Dhairya-Dev-Singh/Pocket-Arcade/CAD/arcade_base.stl

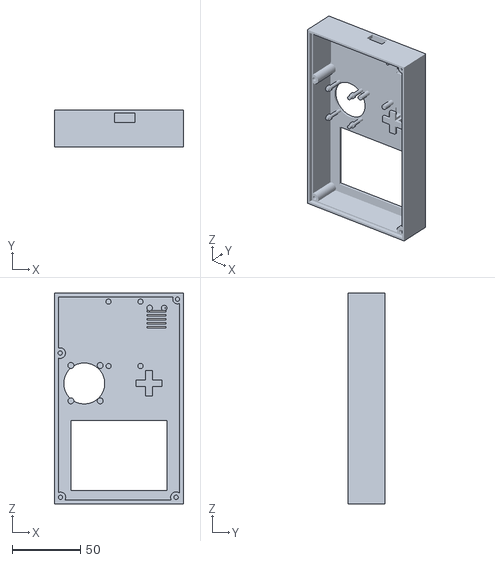
[picture p1: CAD file, 2026-11-06]
CAD/arcade_base.stl
95.0 x 27.0 x 155.0
