Dhairya-Dev-Singh/Pocket-Arcade/CAD/arcade_top.stl

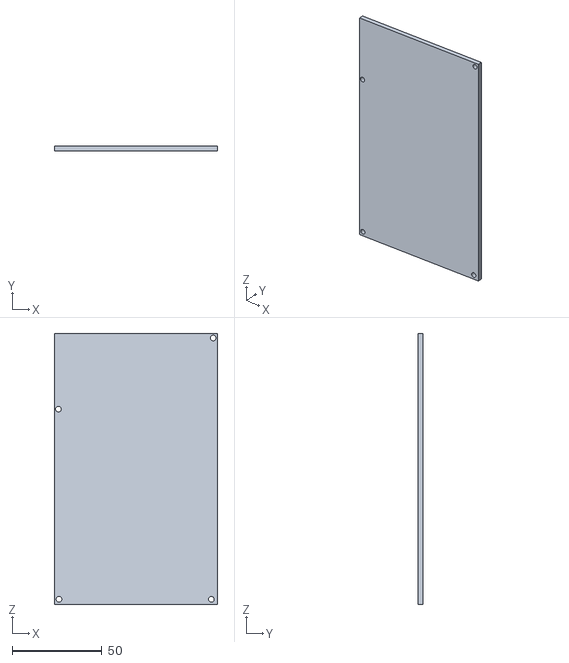
[picture p2: CAD file, 2026-11-06]
CAD/arcade_top.stl
91.0 x 3.00 x 151.0
