Dhairya-Dev-Singh/Pocket-Arcade/(commit log)

2026-11-06 3D files
    [arcade.f3z, arcade.step, arcade_base.stl, arcade_top.stl]
2026-11-06 Rename bom (2).csv to bom.csv
    [bom.csv]
2026-11-06 Document project setup and README details in JOURNAL.md
    Updated JOURNAL.md to include details about setting up the GitHub repository for the Pocket Arcade project, organizing project files, and writing the README with component information and wiring details.
